dxcfl/fall-detection-with-sony-spresense/README.md

# fall-detection-with-sony-spresense
Fall detection w/ Sony Spresense &amp; LTE extension board

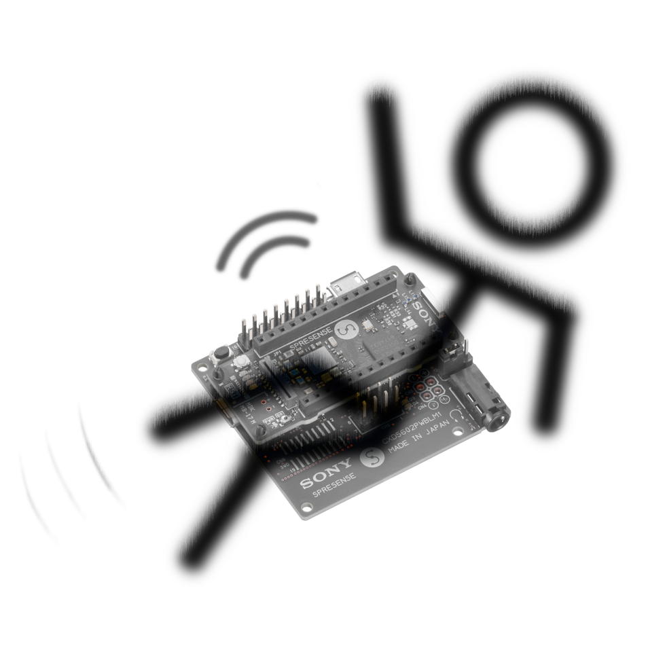
[picture p1: assets/images/cover.png]
cover


## Introduction

For people, especially elderly people, experiencing a fall unnoticed by others can have severe health consequences. Besides the obvious possibility of injuries as direct result of the impact, further health damage is often the consequence if medical aid and treatment cannot be obtained within a short time. The accident situation gets aggravated, if the person is no longer able to call for help due to immobility or unconsciousness. A lot of research has been done and many articles have been published on the topic of building devices for fall detection using accelerometers. This project makes use of some of this knowledge to implement a very simple solution as a proof of concept featuring the Sony Spresense with the Spresense LTE extension board.

## Components

### Hardware

* [Sony Spresense](https://developer.sony.com/develop/spresense/) main board

* [Spresense LTE extension board](https://developer.sony.com/develop/spresense/spresense-lte/)

* [MPU-6050](https://invensense.tdk.com/products/motion-tracking/6-axis/mpu-6050/) 3-axis accelerometer and 3-axis gyroscope sensor e.g. the [GY-521 MPU-6050 3-axis gyroscope and acceleration sensor board](https://www.az-delivery.de/en/products/gy-521-6-achsen-gyroskop-und-beschleunigungssensor) 

#### Sony Spresense Main Board - CXD5602

The Sony Spresense  is a low-power board computer for the IoT that is equipped with a GPS receiver and supports High-Resolution Audio codecs. It's a compact development board based on Sony’s power-efficient multicore microcontroller CXD5602, which to develop applications in short time and is supported by the Arduino IDE.
Main features:
* Integrated GPS - The embedded GNSS with support for GPS, QZSS and GLONASS enables applications where tracking is required.
* Hi-res audio output and multi mic inputs - Advanced 192kHz/24 bit audio codec and amplifier for audio output, and support for up to 8 mic input channels.
* Multicore microcontroller: The Spresense is powered by Sony's CXD5602 microcontroller (ARM® Cortex®-M4F × 6 cores), with a clock speed of 156 MHz.

For more details see [here](https://developer.sony.com/develop/spresense/).

#### Sony Spresense LTE Extension Board

The Spresense LTE Extension Board adds LTE connectivity to the Spresense main board and carries an onboard antenna and a nanoSIM cardholder. Employing the Sony ALT1250 chipset, it ensures compliance with LTE-M (LTE Cat-M1) and NB-IoT communication standards.
It also extends the interfaces of the Spresense main board with multiple mic inputs, a headphone jack, and a microSD card slot. The Spresense main board and the Spresense LTE extension board are connected by a board-to-board connector.

For more details see [here](https://developer.sony.com/develop/spresense/spresense-lte/).

#### MPU-6050 Six-Axis (Gyro + Accelerometer) MEMS MotionTracking™ Device

The MPU6050 sensor chip combines a 3-axis gyroscope, a 3-axis accelerometer and a digital thermometer. The built-in hardware DMP (Digital Motion Processor) unit facilitates the conversion of processed data from all three sensors to a specific position relative to the Earth, thus relieving the microcontroller. It features three 16-bit analog-to-digital converters (ADCs) each for digitizing the gyroscope and  accelerometer outputs. For precision tracking of both fast and slow motions, the parts feature a user-programmable gyroscope full-scale range of ±250, ±500, ±1000, and ±2000°/sec (dps) and a user-programmable accelerometer full-scale range of ±2g, ±4g, ±8g, and ±16g.

For more details see [here](https://invensense.tdk.com/products/motion-tracking/6-axis/mpu-6050/)

### Software / Libraries / Services

* [Arduino IDE](https://www.arduino.cc/en/software)
* [Spresense Arduino Library](https://developer.sony.com/develop/spresense/docs/arduino_developer_guide_en.html) (LTE, RTC, SDHCI, File etc.)
* [Adafruit MPU6050](https://www.arduino.cc/reference/en/libraries/adafruit-mpu6050/) library 
* [ArduinoHTTPClient](https://www.arduino.cc/reference/en/libraries/arduinohttpclient/) library
* [Signal Messaging App](https://signal.org/)
* [CallMeBot](https://www.callmebot.com/) API

Description: see below.

### Additional components

* MicroSD card
* SIM (nano formfactor)
* Wires

## Fall Detection

The idea for this project is, to use an accelerometer and gyroscope sensor, to detect a fall situation and to alert another individual or organisation via LTE.

It is assumed this prototype is part of a device (Spresense board(s) + sensor + battery + casing) that can be worn e.g. clipped to a belt of a person.

The fall detection algorithm focuses on the total acceleration – the "sum" of the acceleration of 3 axes – defined as
total acceleration

It is based on the concept that during a fall, a person experiences a momentary freefall – a reduction in acceleration toward zero, followed by a large spike in acceleration on the impact and a sudden change in orientation (e.g., from standing to lying) – all this within a time interval of one second or less.

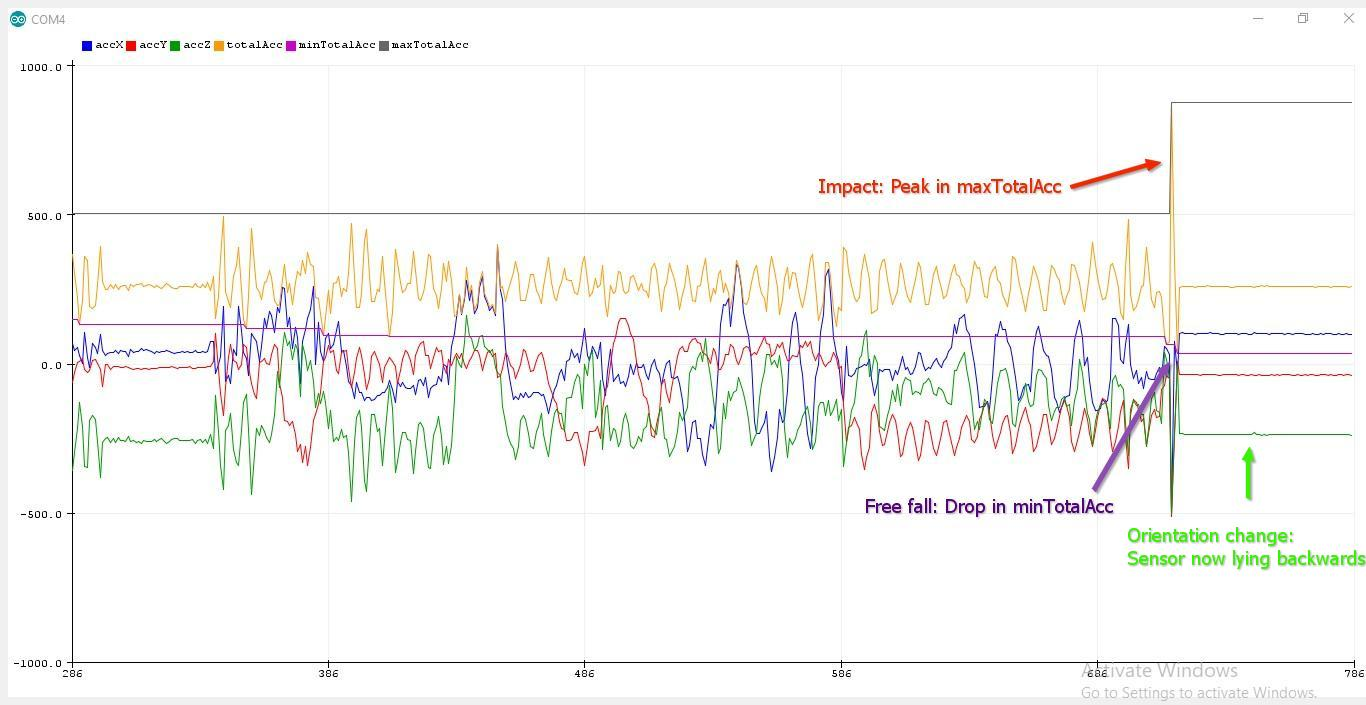
[picture p2: assets/images/acceleration_readings_plot.jpg]
total acceleration


If all these three events (free fall, impact and orientation change) in acceleration have been observed within a short time interval (a second or less), it is assumed that the device has observed the user falling down.

While the free fall and impact events can be easily derived by just comparing the total acceleration against given thresholds, detecting a sudden orientation change can be observed in more simple way by regarding the magnitude of the rotation speed obtained from a 3-axis gyroscope.

Based on the readings of a combined 3-axis accelerometer and gyroscope these three trigger events can be measured as

* $trigger_{fall}$ :=  $\sqrt{X_{acceleration}^2 + Y_{acceleration}^2 + Z_{acceleration}^2}$ < $threshold.fall_{acceleration}$  
* $trigger_{impact}$ := $\sqrt{X_{acceleration}^2 + Y_{acceleration}^2 + Z_{acceleration}^2}$ > $threshold.impact_{acceleration}$ 
* $trigger_{orientation change}$ := $\sqrt{X_{rotation}^2 + Y_{rotation}^2 + Z_{rotation}^2}$ > $threshold.orientation_{rotation}$ 

These conditions are evaluated with each sensor reading cycle. 
* If a trigger is evaluated  to $true$ the timestamp $time_{<trigger>}$ is recorded.
* If $time_{current} - time_{<trigger>} < timespan_{observation}$ for all three triggers it is assumed that a fall has been observed.

## Alarm

If a fall has been detected an alert message is sent to person or an organisation who then can look after the monitored individual  and provide help if necessary.

For this prototype the alert message is sent via [Signal](https://signal.org/) Messaging using the [CallMeBot](https://www.callmebot.com/) API.

[Signal](https://signal.org/) is a cross-platform centralized encrypted instant messaging service developed by the non-profit Signal Foundation and Signal Messenger LLC. Users can send one-to-one and group messages, which can include files, voice notes, images and videos. It uses standard cellular telephone numbers as identifiers and secures all communications to other Signal users with end-to-end encryption. 

[CallMeBot](https://www.callmebot.com/) provides an easy to use free API to send text messages (like notifications) and images through various messaging applications (like Signal, Telegram, WhatsApp etc.)using one simple API call from any device (Home Assistant, OpenHab, ioBroker, IFTTT, etc...). 

To use the API for sending messages to a recipient, it is necessary to obtain an API key for this recipient. This can be easily achieved by sending a specific message to the CallMeBot service from the receiving app/device:

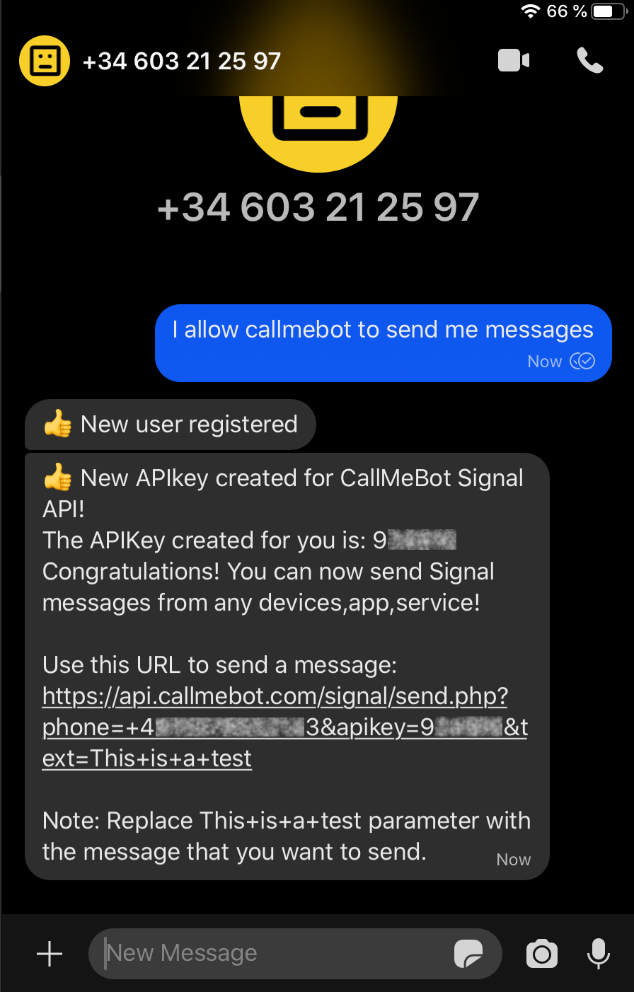
[picture p3: assets/images/CallMeBot_registration.png]
CallMeBot registration


For more details about the service and the registration process see [here](https://www.callmebot.com/blog/free-api-signal-send-messages/).

## Implementation

### Prerequisites

This implementation is based on the [Spresense Arduino Library](https://github.com/sonydevworld/spresense-arduino-compatible), so it's required to setup the environment as described in the [Spresense Arduino Library Getting Started Guide](https://developer.sony.com/develop/spresense/docs/arduino_set_up_en.html).

Additionally, the following libraries need to be installed, preferably using the Library Manager of the Arduino IDE:

* The [Adafruit MPU6050](https://www.arduino.cc/reference/en/libraries/adafruit-mpu6050/) library for accessing the MP6050 sensor and
* the [ArduinoHTTPClient](https://www.arduino.cc/reference/en/libraries/arduinohttpclient/) library for making the API call to CallMeBot via HTTP(S).

For the LTE connectivity an appropriate activated unlocked SIM (with PIN deactivated) is required.

For the communication with the CallMeBot service via HTTPS it is necessary to store the root certificate of the CallMeBot web service on a FAT formatted microSD card. For details about the procedure refer to the example [here](https://developer.sony.com/develop/spresense/docs/arduino_tutorials_en.html#_tutorial_LteHttpSecureClient) and the guide [here](https://developer.sony.com/develop/spresense/docs/arduino_tutorials_en.html#lte_howtoexport_cert).
The current valid root CA for the CallMeBot API service - the ISRG Root X1 CA -  can also be found [here](/assets/miscellaneous/isrg_root_x1_dst_root_ca_x3_.cer).

### Wiring

The MPU6050 module communicates through I2C with the default default I2C address 0x68. For details about using I2C with Spresense LTE extension board and the Spresense Arduino Wire Library refer to the [Spresense Hardware Documentation](https://developer.sony.com/develop/spresense/docs/hw_docs_lte_en.html#_how_to_use_i2c) and the [Spresense Arduino Library Developer Guide - Wire Library](https://developer.sony.com/develop/spresense/docs/arduino_developer_guide_en.html#_wire_library)

The MPU6050 is connected to Spresense LTE extension board as follows:

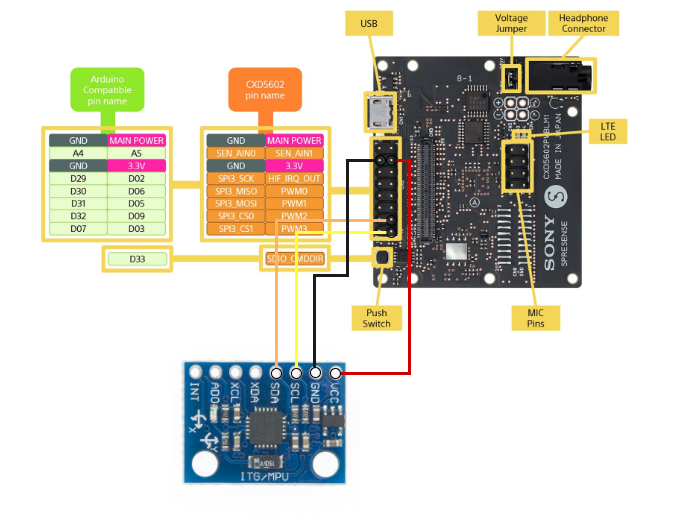
[picture p4: assets/images/wiring_diagr.png]
wiring


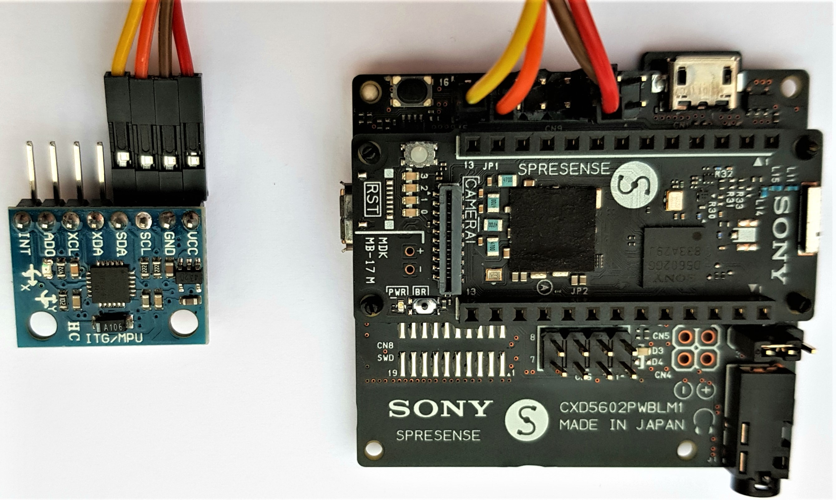
[picture p5: assets/images/wiring_photo.jpg]
wiring


The *SDA* connector on the MPU6050 board is connected to pin *D03* (*PWM3*) on the Spresense LTE extension board and the *SCL* connector is wired to pin *D09* (*PWM2*).

### Code

The code for this project is split into multiple separate sketch files for better readability:

* accelerometer_and_gyroscope.ino
* app_settings.h
* fall_detection.ino
* lte_web_client.ino

#### accelerometer_and_gyroscope.ino

This sketch file contains code for the initialization of the MPU6050 board and for obtaining the sensor readings for the 3-axis accelerometer and the 3-axis gyroscope. 

#### app_settings.h

This file contains the parameter settings for the application:
* thresholds for the fall detection function:
    - *APP_FD_DETECTION_TIME_INTERVAL* in milliseconds
    - *APP_FD_FREE_FALL_ACCELERATION_THRESHOLD* in $m/s^2$ 
    - *APP_FD_IMPACT_ACCELERATION_THRESHOLD* in $m/s^2$
    - *APP_FD_ORIENTATION_CHANGE_THRESHOLD* in $rad/s$
* parameters for the CallMeBot API:

        #define APP_SEND_MESSAGE_HOST "api.callmebot.com" 
        #define APP_SEND_MESSAGE_PORT 443
        #define APP_SEND_MESSAGE_PATH "/signal/send.php?phone=<phone number>&apikey=<api key>&text=Alert%3A%20Fall%20detected%21"
        #define APP_ROOTCA_FILE "isrg_root_x1_dst_root_ca_x3_.cer
* settings for the LTE connectivity (APN, user, password etc.)

#### fall_detection.ino

This is the main sketch. It contains the "application logic" 

    void loop()
        {
        float accX, accY, accZ;
        float gyrX, gyrY, gyrZ;
        bool fall_detected;

        read_acceleration_and_rotation(&accX, &accY, &accZ, &gyrX, &gyrY, &gyrZ);
        fall_detected = fall_detection(accX, accY, accZ, gyrX, gyrY, gyrZ);

        if (fall_detected)
        {
            send_request();
        }
    }

and the fall detection function:

    bool fall_detection(float accX, float accY, float accZ, float gyrX, float gyrY, float gyrZ)
    {
        bool freeFallTrigger, impactTrigger, orientationChangeTrigger;

        // Thresholds and interval
        const unsigned long detectionInterval = APP_FD_DETECTION_TIME_INTERVAL;
        const float freeFallThreshold = APP_FD_FREE_FALL_ACCELERATION_THRESHOLD;
        const float impactThreshold = APP_FD_IMPACT_ACCELERATION_THRESHOLD;
        const float orientationChangeThreshold = APP_FD_ORIENTATION_CHANGE_THRESHOLD;

        // Last detection time for each trigger
        static unsigned long timeFreeFall = 0;
        static unsigned long timeImpact = 0;
        static unsigned long timeOrientationChange = 0;

        unsigned long currentTime = millis();

        // Total acceleration and rotation for all three axes
        float totalAcc = total(accX, accY, accZ);
        float totalRot = total(gyrX, gyrY, gyrZ);
        
        // Free fall detected: Total acceleration below defined threshold
        if (totalAcc <= freeFallThreshold)
        {
            timeFreeFall = currentTime;
        }

        // Impact detected: Total acceleration above defined threshold
        if (totalAcc >= impactThreshold)
        {
            timeImpact = currentTime;
        }

        // Orientation change detected: Total rotation above defined threshold
        if (totalRot >= orientationChangeThreshold)
        {
            timeOrientationChange = currentTime;
        }

        // Events triggered within defined time interval?
        freeFallTrigger = (currentTime - timeFreeFall < detectionInterval);
        impactTrigger = (currentTime - timeImpact < detectionInterval);
        orientationChangeTrigger = (currentTime - timeOrientationChange < detectionInterval);

        // Fall detected: All three triggers occured within defined time interval.
        return freeFallTrigger && impactTrigger && orientationChangeTrigger;
    }

#### lte_web_client.ino

This sketch part is based on the example [Checking HTTP Client behavior using the TLS protocol](https://developer.sony.com/develop/spresense/docs/arduino_tutorials_en.html#_tutorial_LteHttpSecureClient) in the [Spresense Arduino Examples & Tutorials](https://developer.sony.com/develop/spresense/docs/arduino_tutorials_en.html)
The *send_request()* function makes the HTTP GET call to the CallMeBot API service to send the predefined message.

## Test

### Device case

For testing the device has been put into a 3D-printed case based on [The sample case for Spresense LTE extension board](https://github.com/sonydevworld/spresense-hw-design-files/tree/master/Case/LTE-Board-Case-Sample):

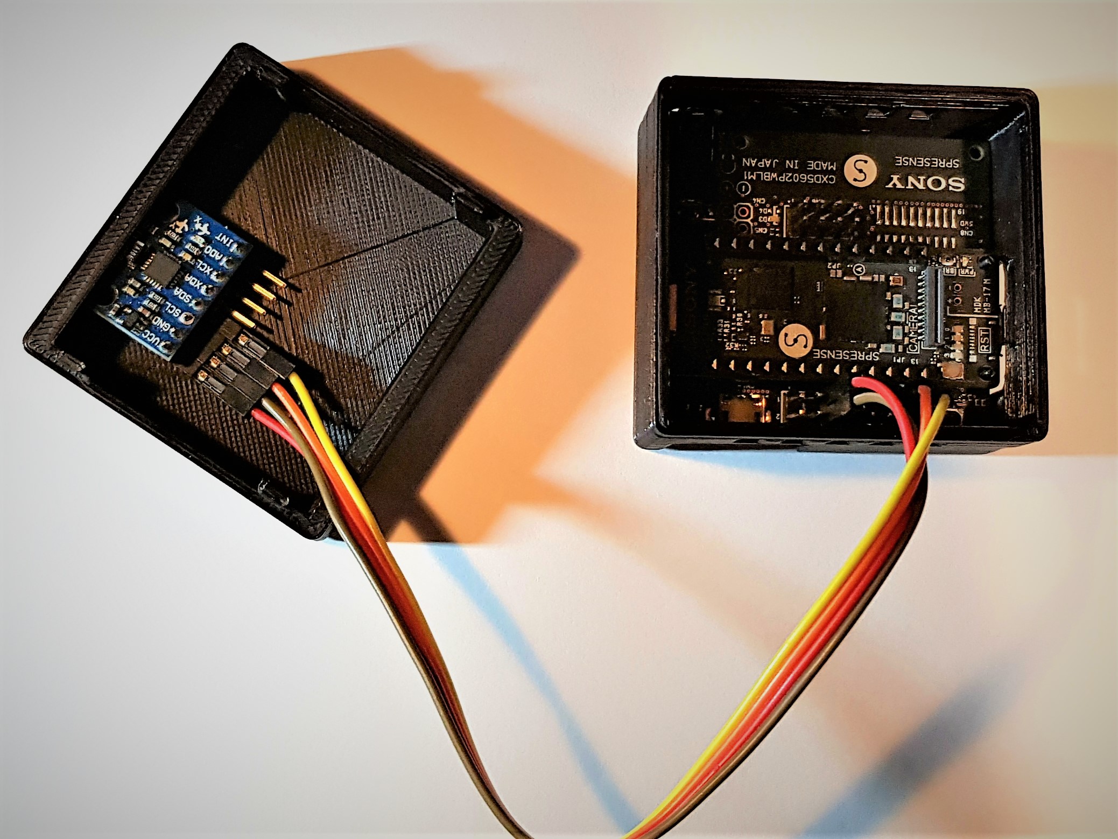
[picture p6: assets/images/case1.jpg]
case (open)


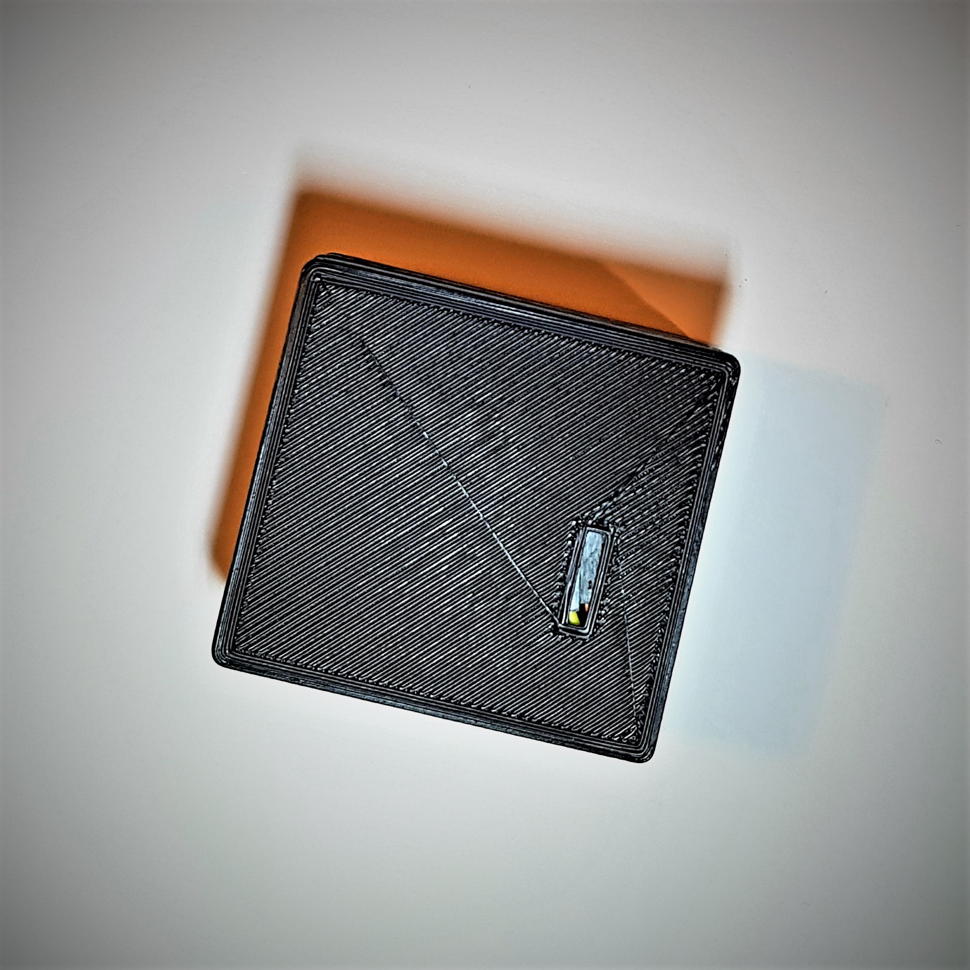
[picture p7: assets/images/case2.jpg]
case (closed)


### Debug output

Application startup:

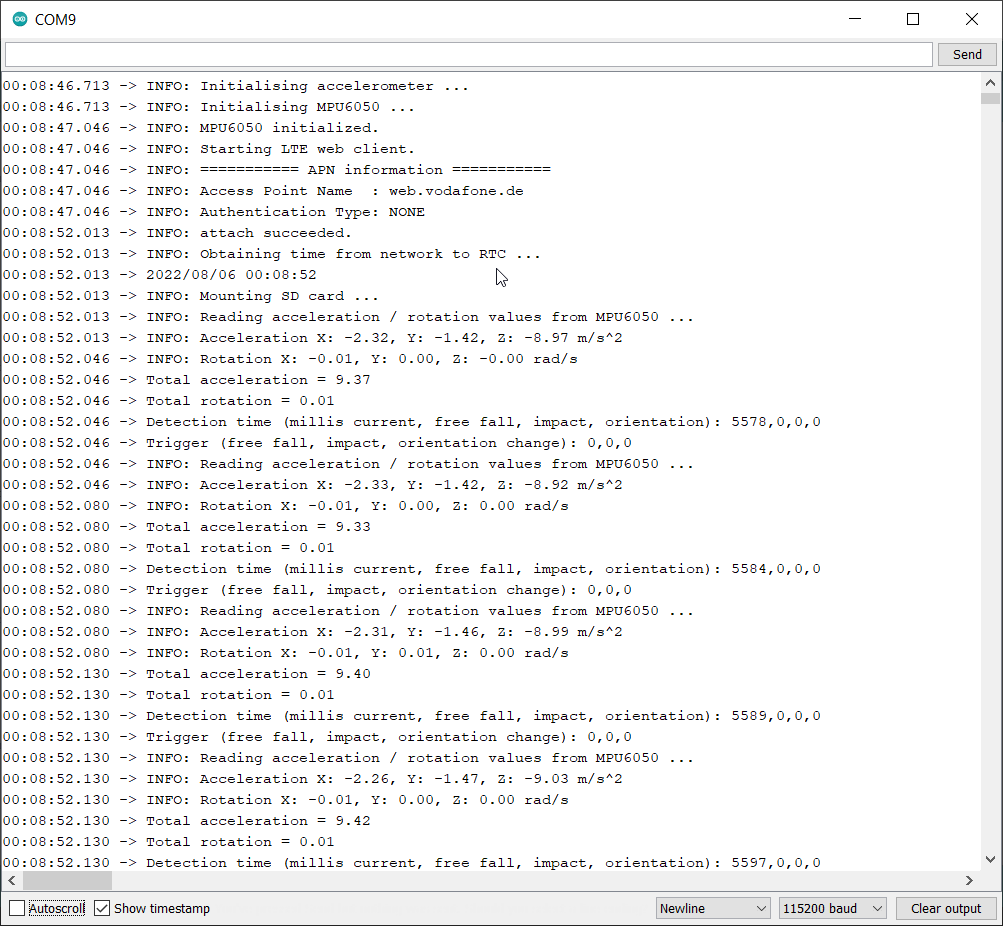
[picture p8: assets/images/test__serial_monitor__start.png]
serial monitor - start


Fall detected & alarm:

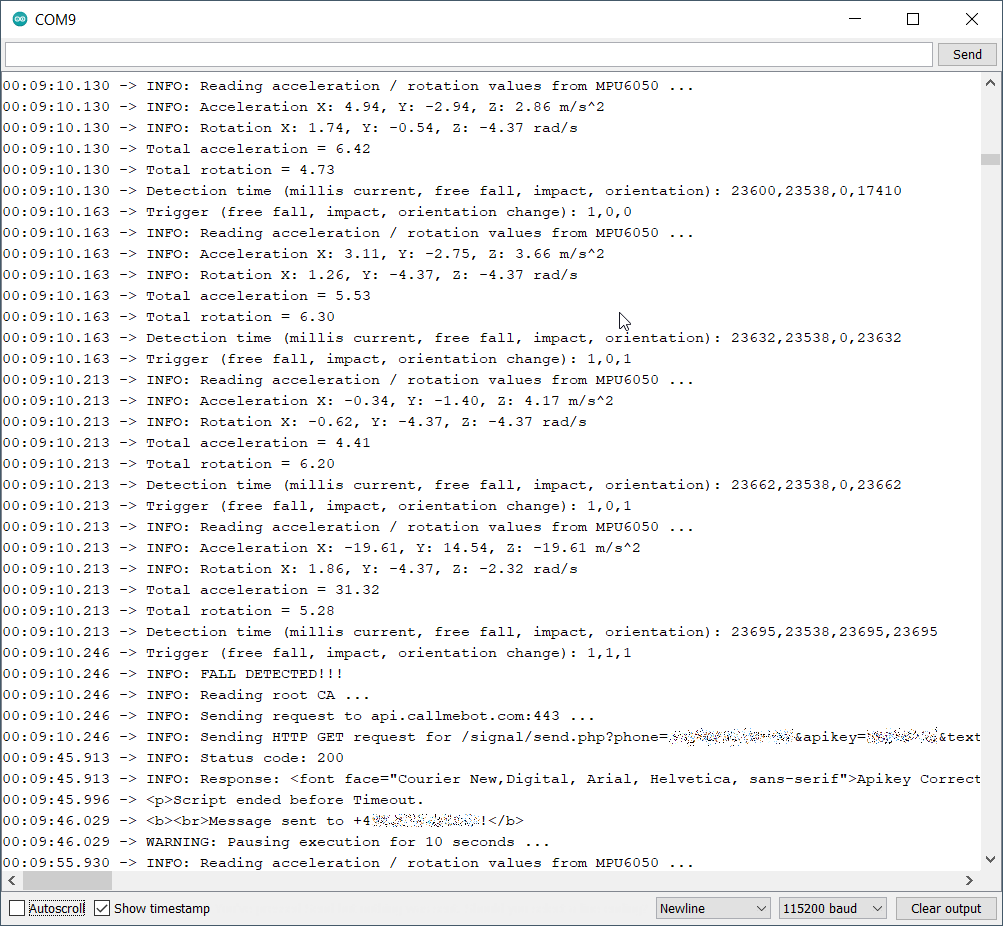
[picture p9: assets/images/test__serial_monitor__fall.png]
serial monitor - fall


### Power consumption:

Detection mode:

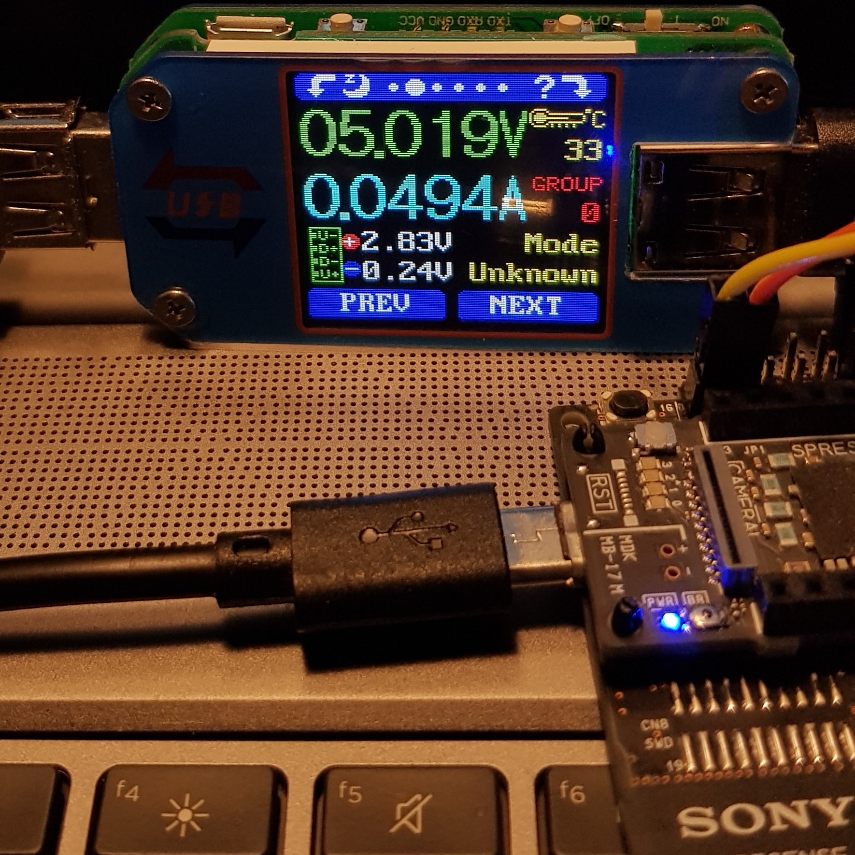
[picture p10: assets/images/power_consumption1.jpg]
power consumption - normal


Alarm:

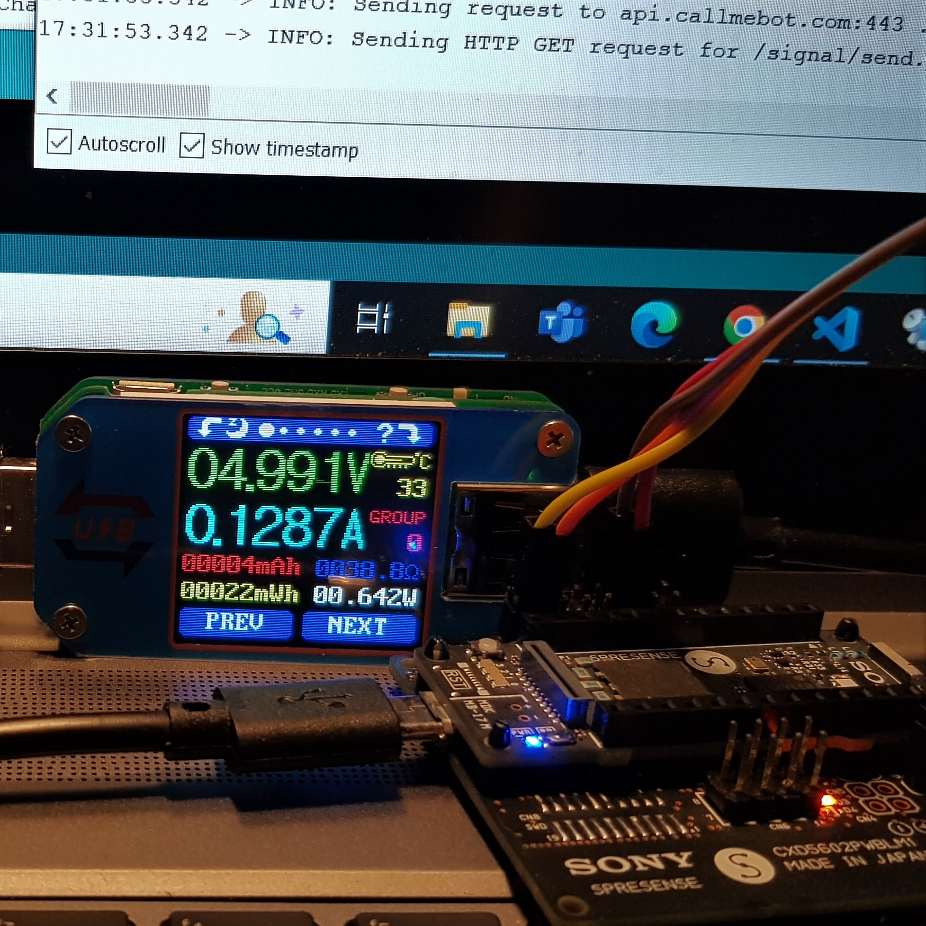
[picture p11: assets/images/power_consumption2.jpg]
power consumption - alarm
