dxcfl/fall-detection-with-sony-spresense/assets/images/math_symbols.png

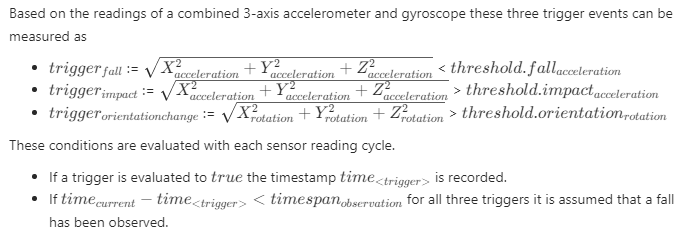
assets/images/math_symbols.png
